harrylf/Dirt-Data/Hydro-sensor and Photosensor .jpg

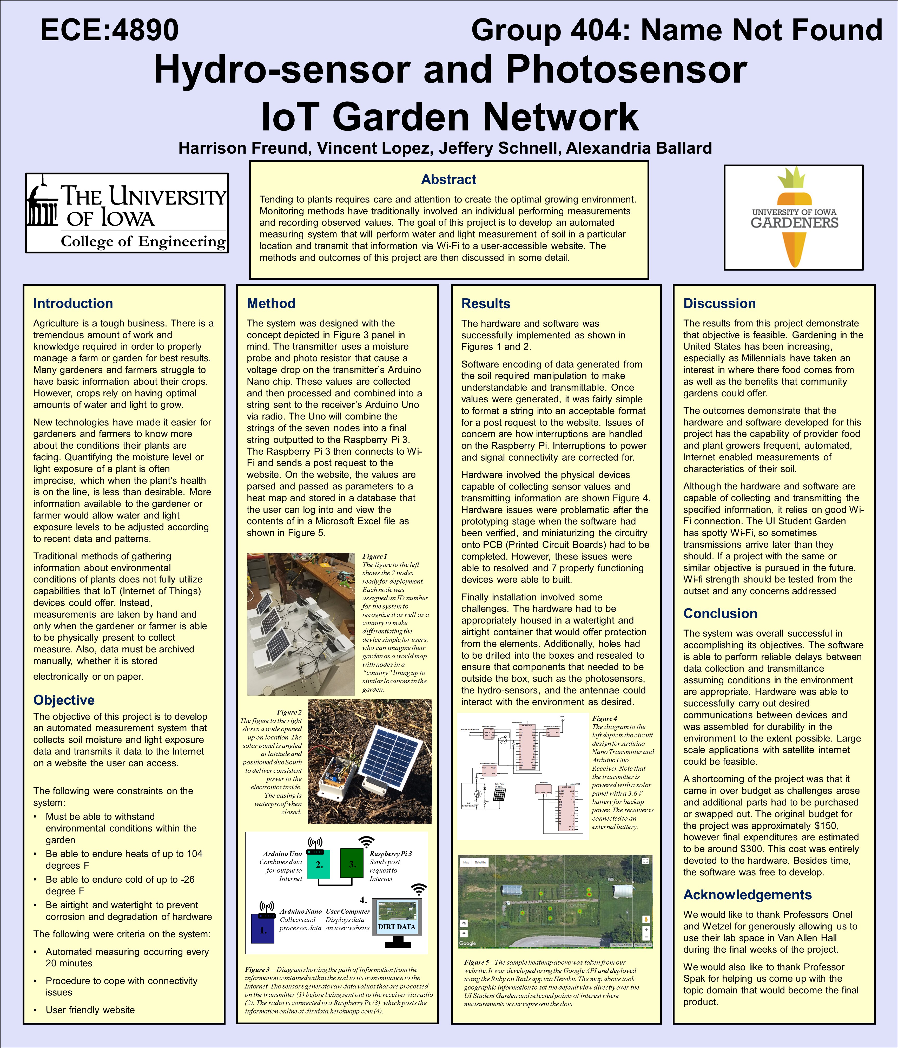
Hydro-sensor and Photosensor .jpg
