harrylf/Dirt-Data/README.md

# Dirt-Data
Sr. Design pursuing wireless transmission of hydro-logical and photo data
