harrylf/Dirt-Data/(commit log)

2018-04-12 heatmap, looks bad
2018-04-25 heatmap toggle
